amaargiru/openlight/Docs/pcb.jpg

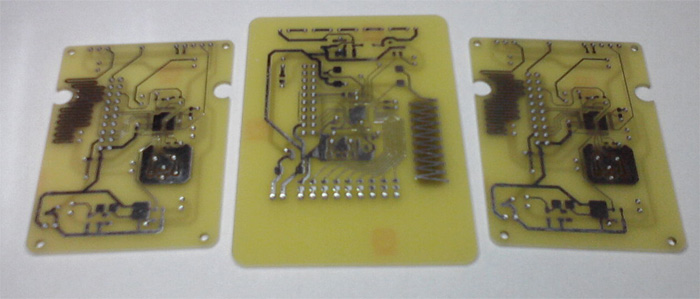
Docs/pcb.jpg
