amaargiru/openlight/README.md

# openlight
Open hardware DIY project of bicycle light with wireless control
