amaargiru/openlight/BOMs/side.bom.xls

Open Light Project, "Side" module, Bill of Materials (BOM)
RefDes | Part | Qty | Description
L1 | LQH32CN100K23L | 1 | SMD inductor
C1, C11 | 10 uF 1206 | 2 | SMD ceramic capacitor
C2 | 150 uF 6.3 V Case C | 1 | SMD tantalum capacitor
C3, C4, C7..C9, C10 | 0.1 uF 0805 | 6 | SMD ceramic capacitor
C5, C6 | 22 pF 0805 | 2 | SMD ceramic capacitor
D1 | STM32F100C4T6B | 1 | ARM Cortex M-3 microcontroller
D2 | TPS61041DBVR | 1 | DC/DC Boost Converter
G1 | 7.3728 MHz Quartz | 1 | HC49U Package
H1..H8 | DFL-5034 R1C-ESD-E | 8 | SuperBright Red LED 5 mm
R1 | 3.3 kOhm 0805 | 1 | SMD resistor
R2 | 82 Ohm 1206 | 1 | SMD resistor
U2 | RR8-433 | 1 | 433 MHz RF receiver
VD1 | MBR0530 | 1 | 0.5 A Schottky Rectifier
X1 | PLD-20 | 1 | 20 pin (2x10) 2.54 mm male JTAG Connector
