amaargiru/openlight/Schematics & PCBs/OL_head_02.pcb.pdf

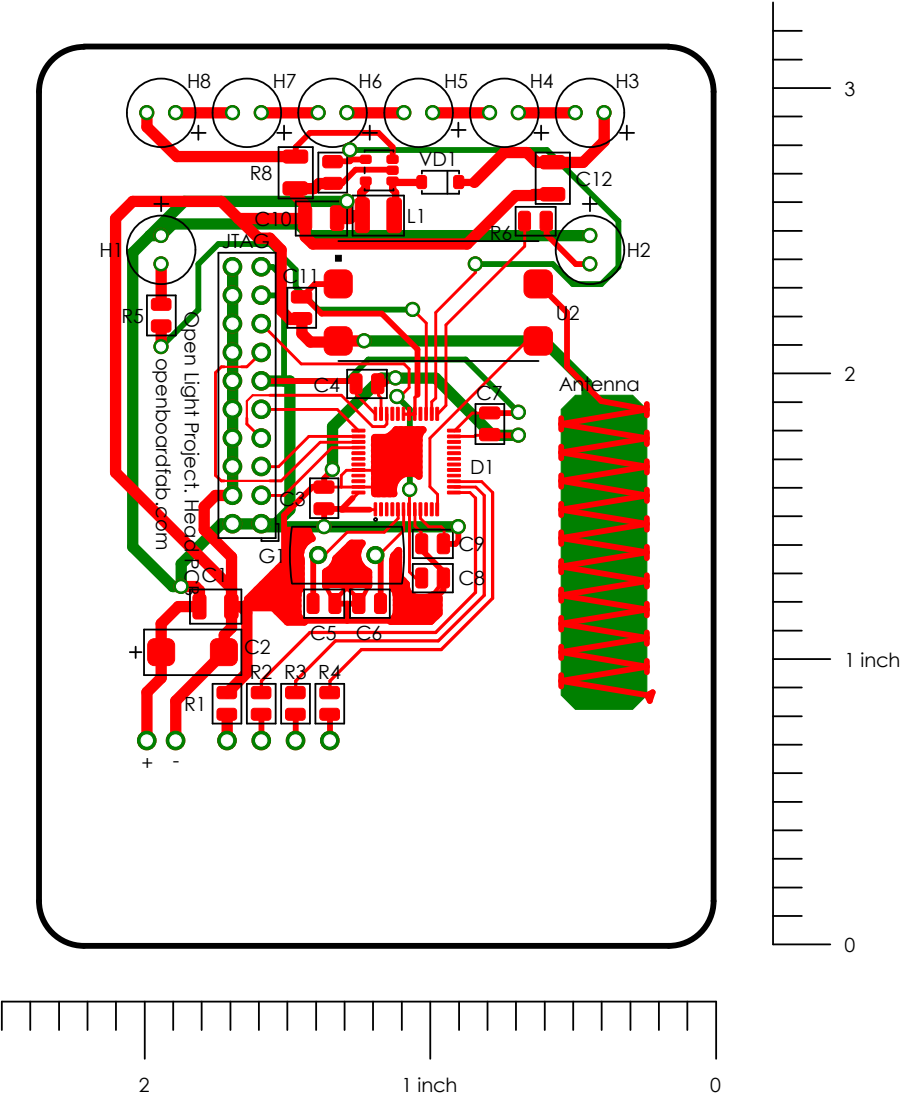
[picture p2: page 1]

Open Light Project. Head PCB
