amaargiru/openlight/Schematics & PCBs/OL_head_02.sch.pdf

# 12 PA2/TXD2/ADC2/TIM23 3

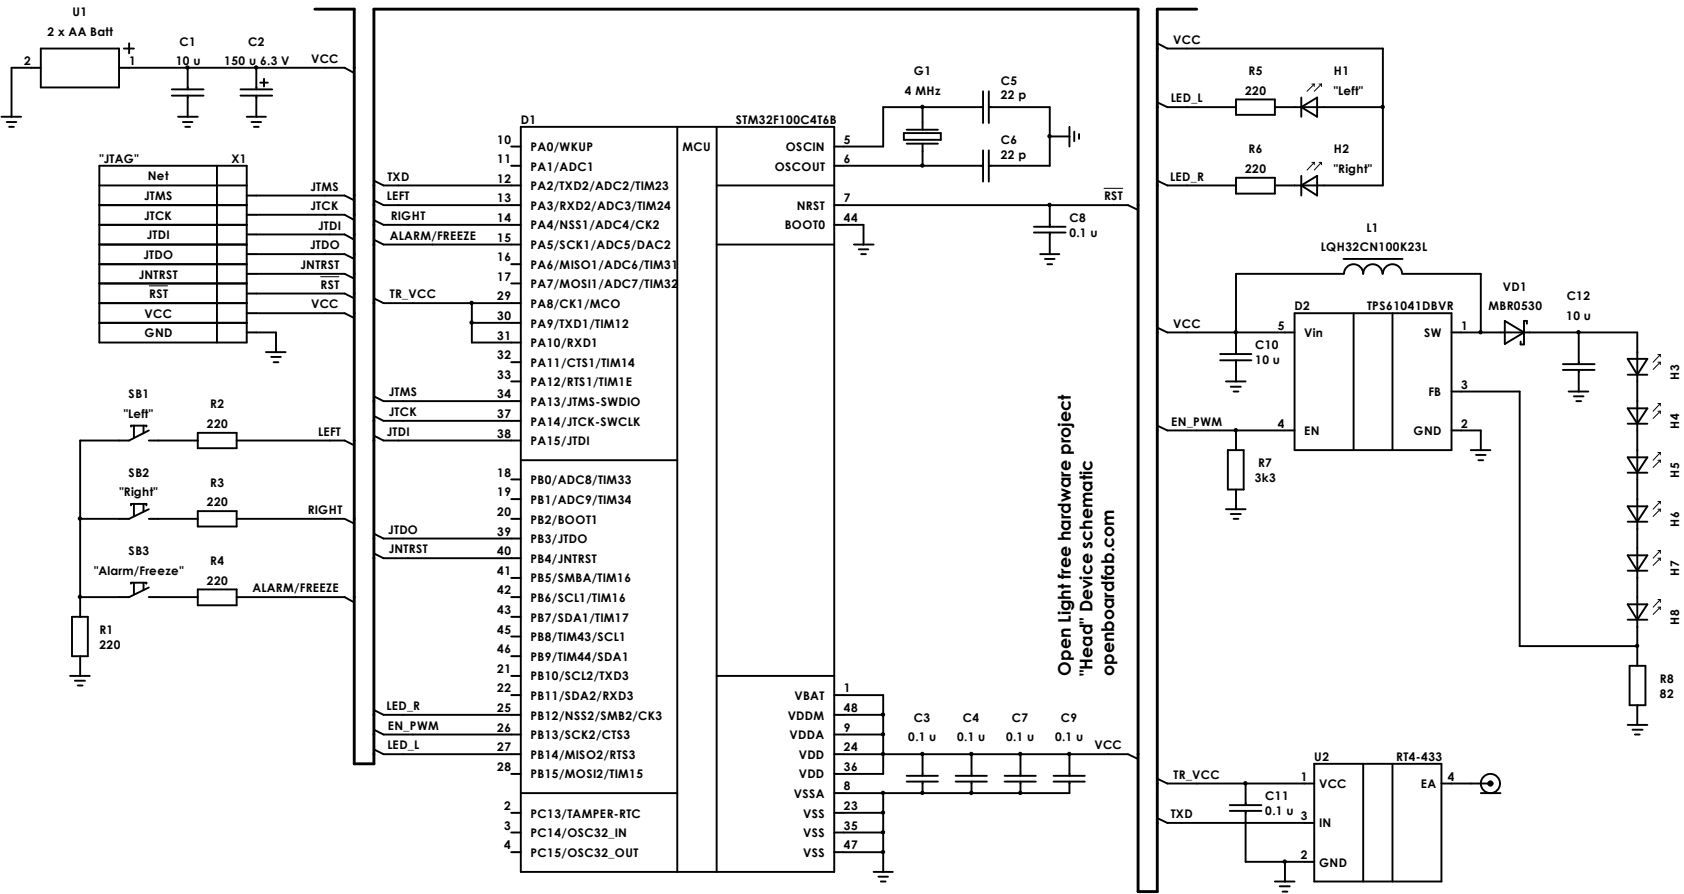
[picture p3: page 1]

JTDO
JNTRST

VCC
GND

Open Light free hardware project
