amaargiru/openlight/Schematics & PCBs/OL_side_02.pcb.pdf

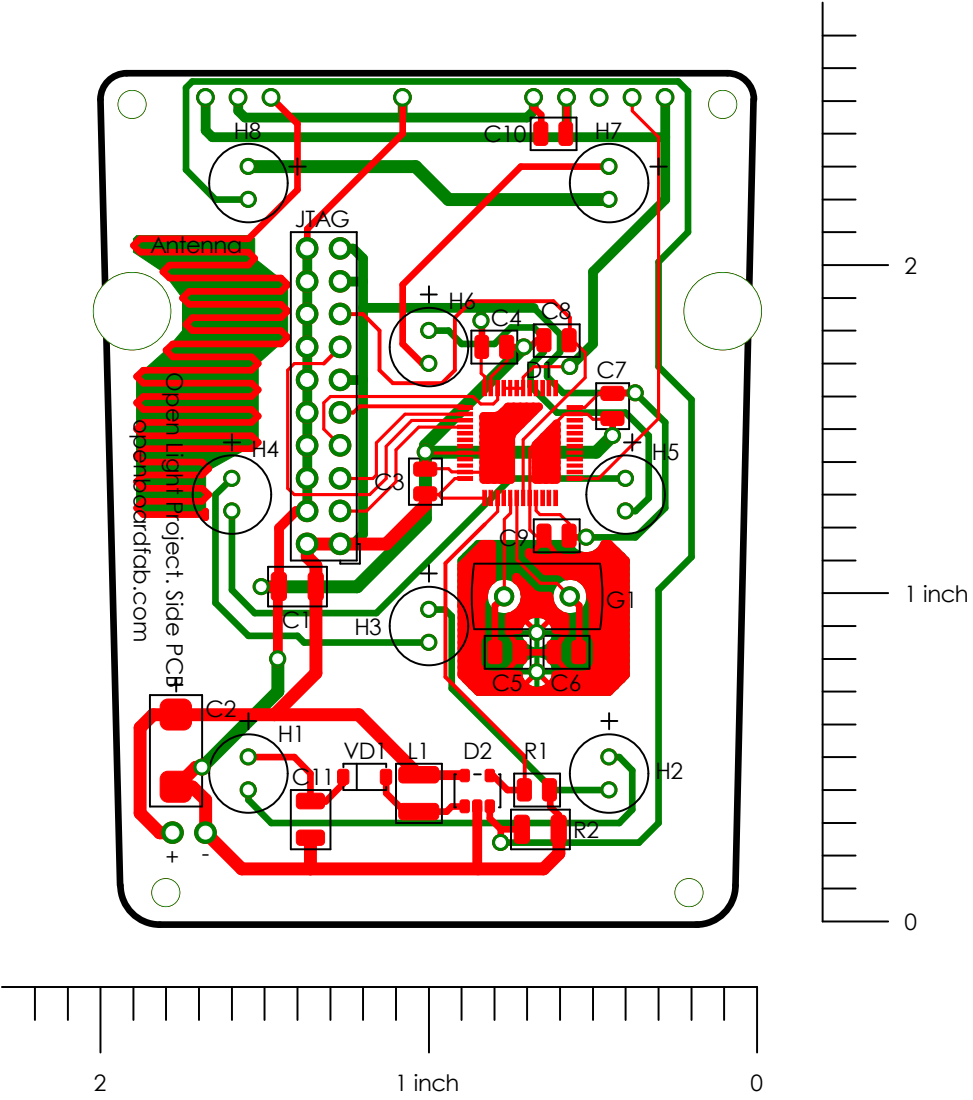
[picture p4: page 1]

Open Light Project. Side PCB
