amaargiru/openlight/Schematics & PCBs/OL_side_02.sch.pdf

# 12 PA2/TXD2/ADC2/TIM23 3

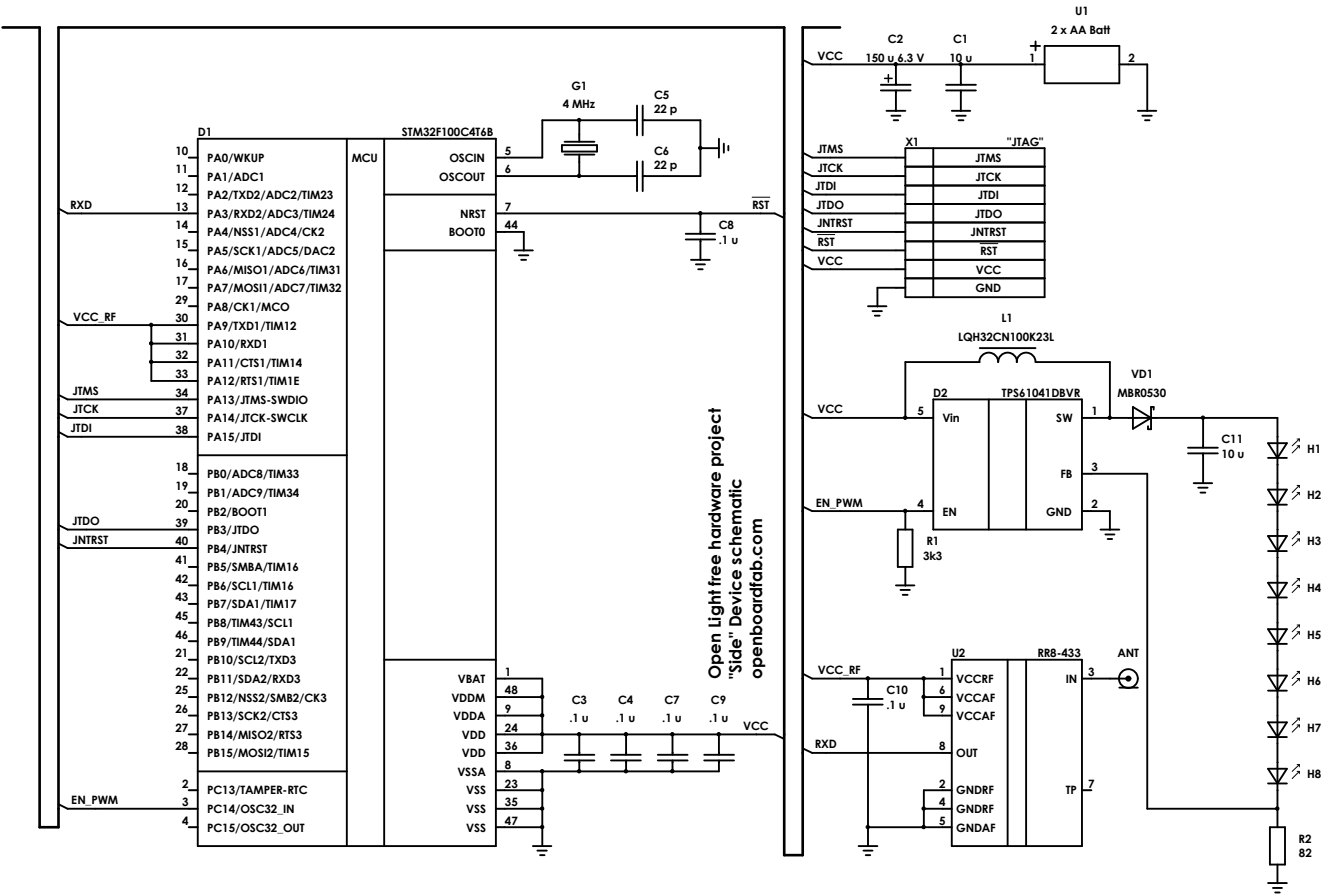
[picture p5: page 1]

JTMS
JTCK
JTDI
JTDO
JNTRST
RST
VCC
GND

Open Light free hardware project
