amaargiru/openlight/Schematics & PCBs/OL_head_02.pcb.bottom.pdf

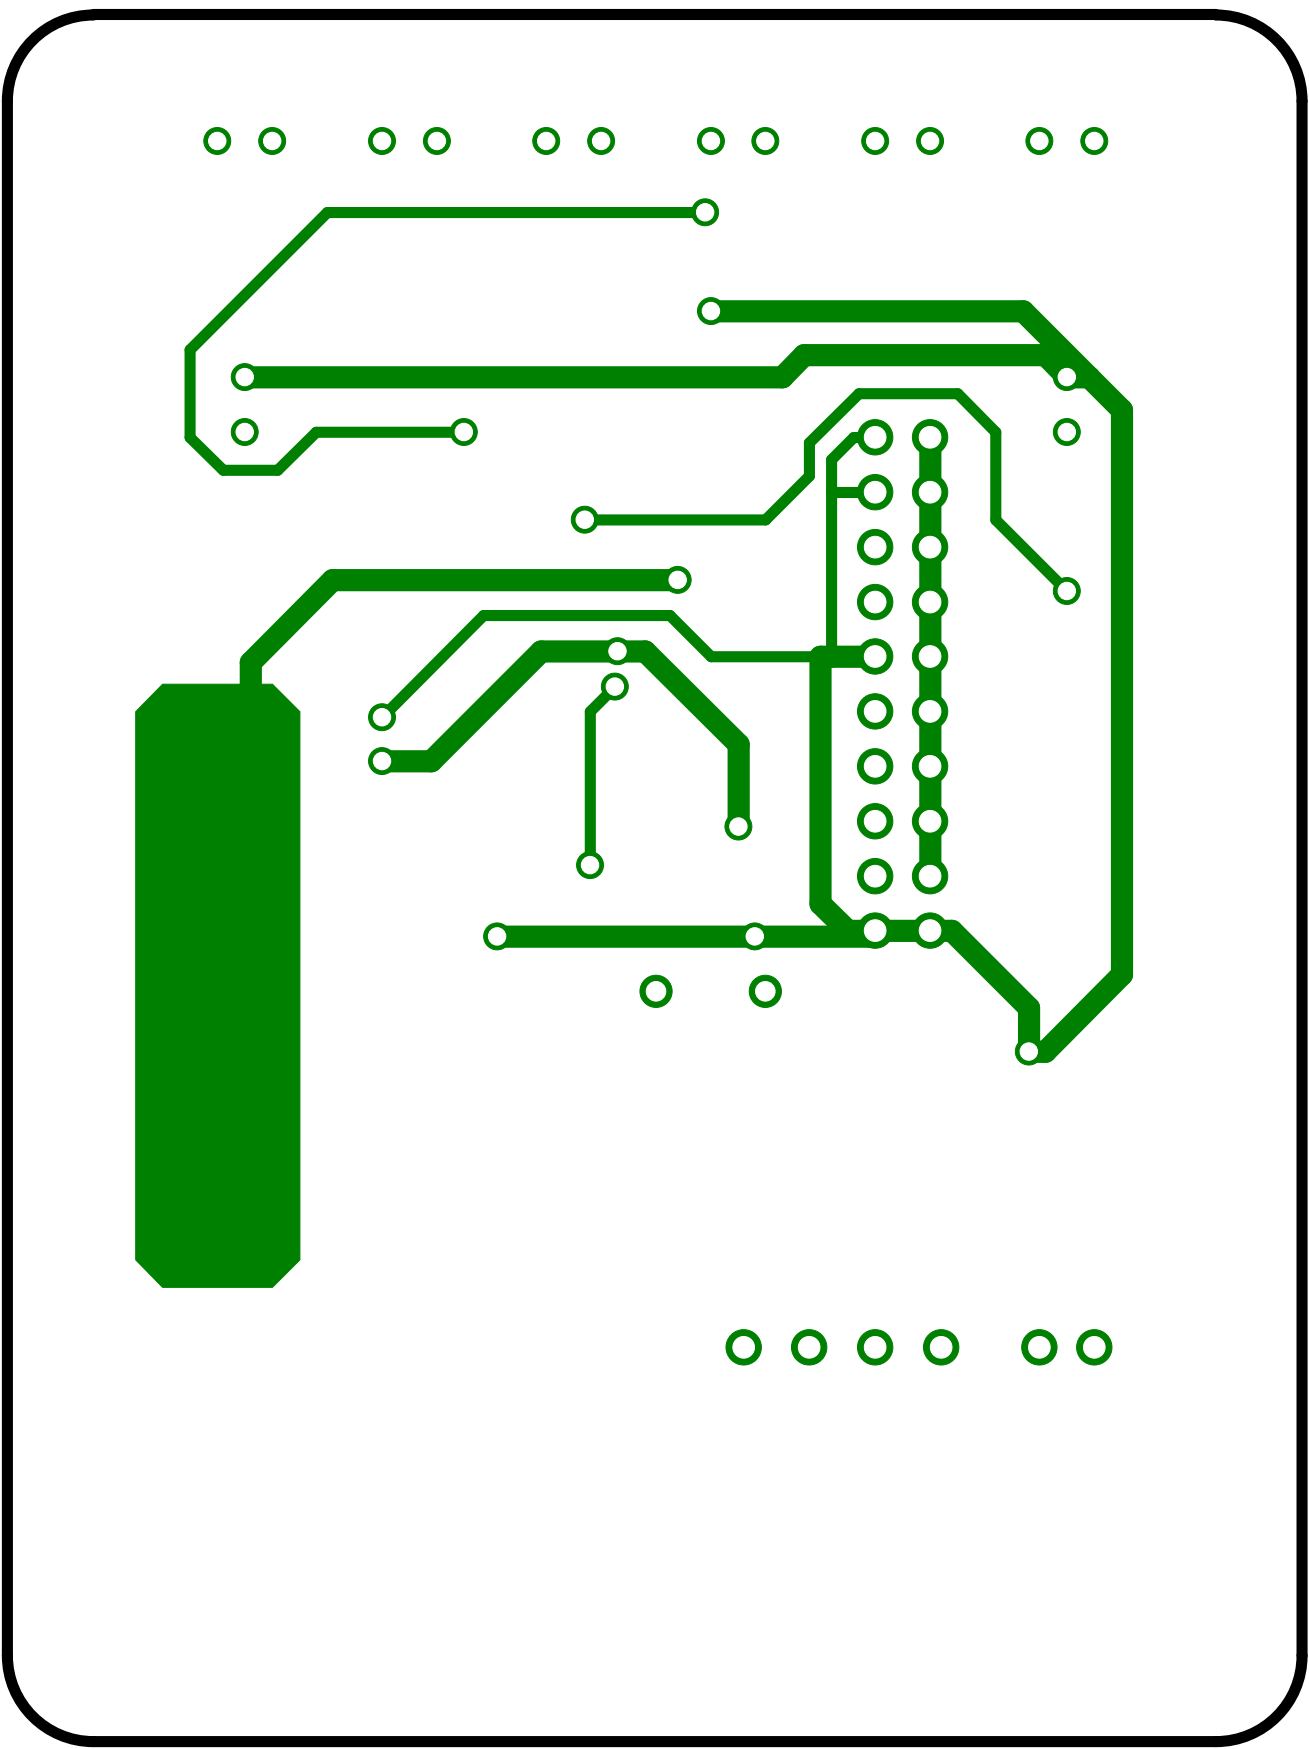
[picture p6: page 1]
