amaargiru/openlight/Schematics & PCBs/OL_head_02.pcb.top.pdf

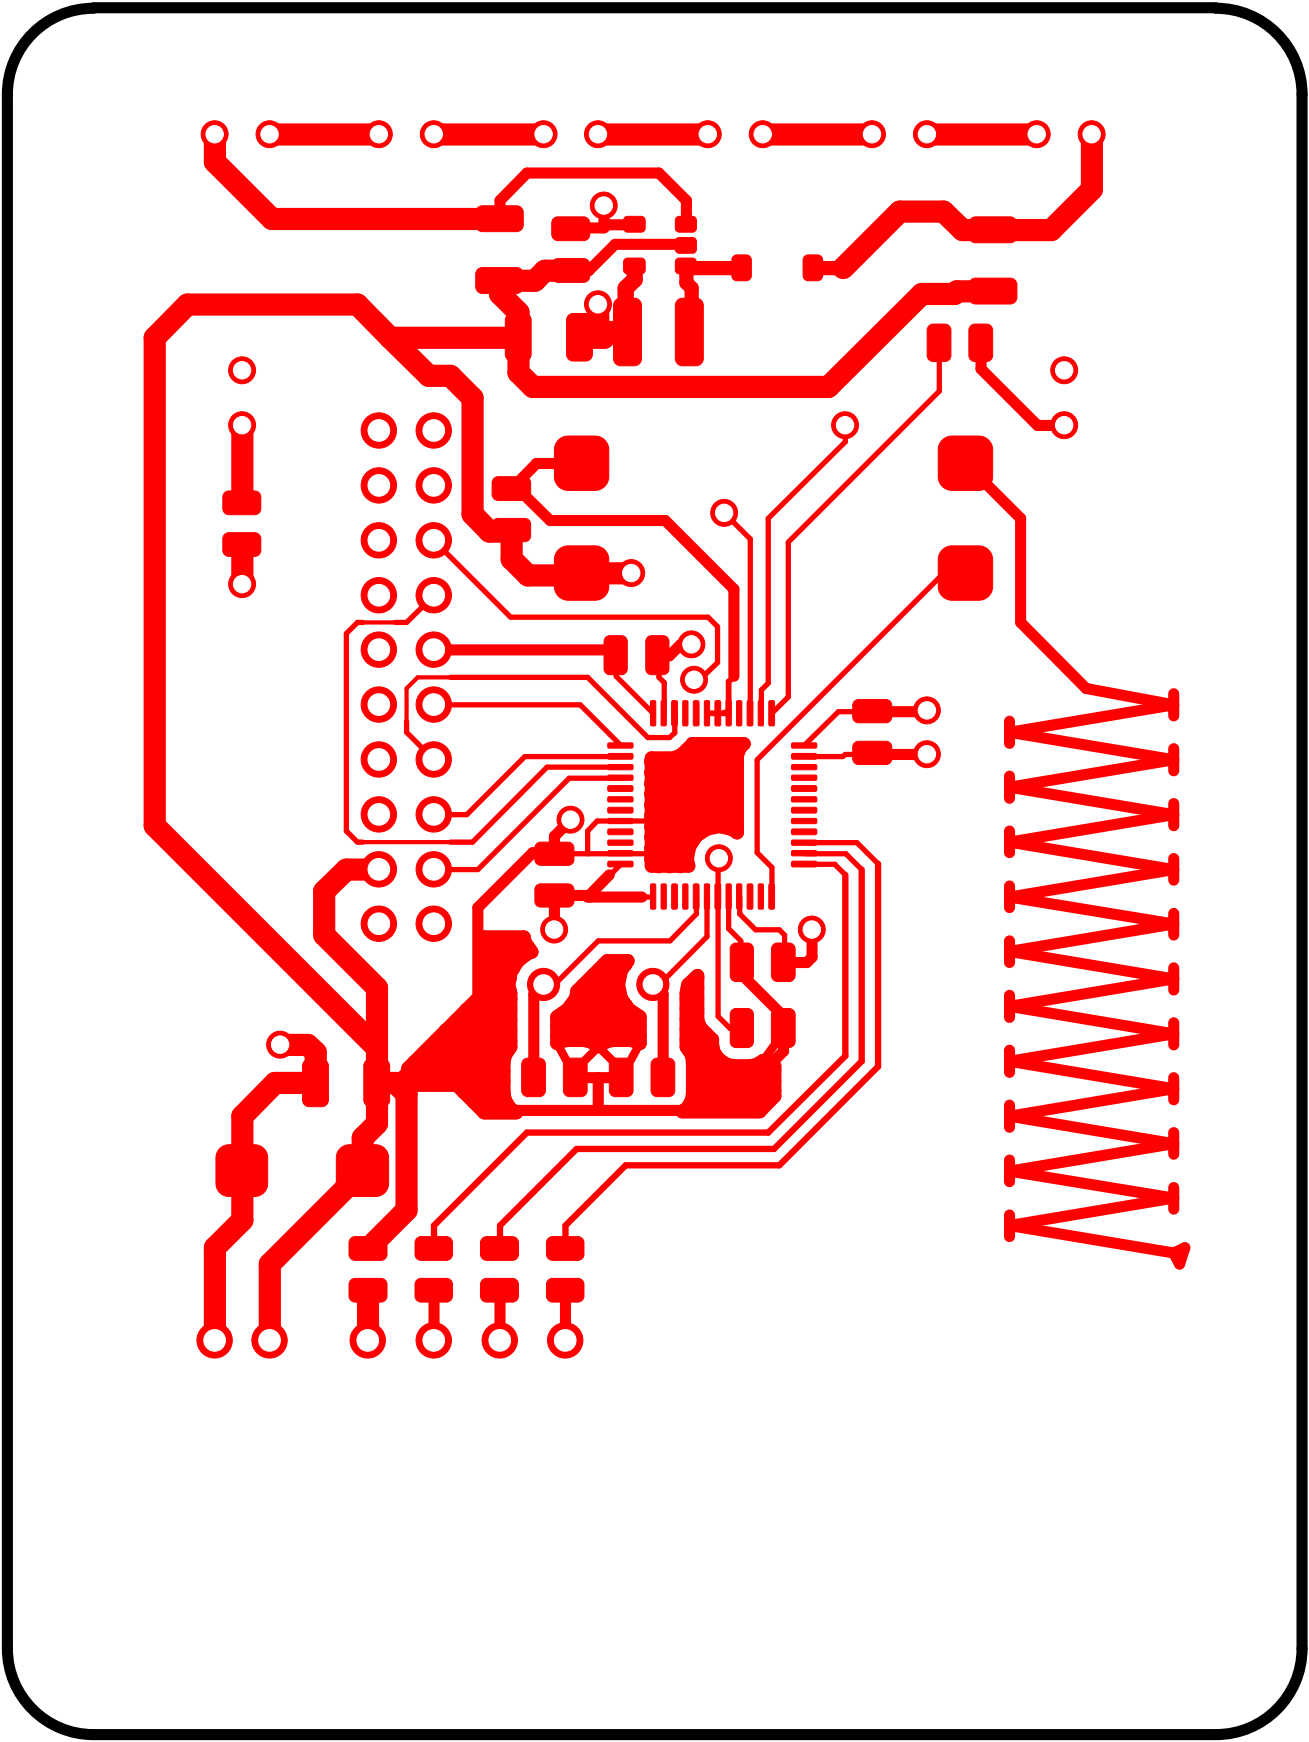
[picture p7: page 1]
