amaargiru/openlight/Schematics & PCBs/OL_side_02.pcb.bottom.pdf

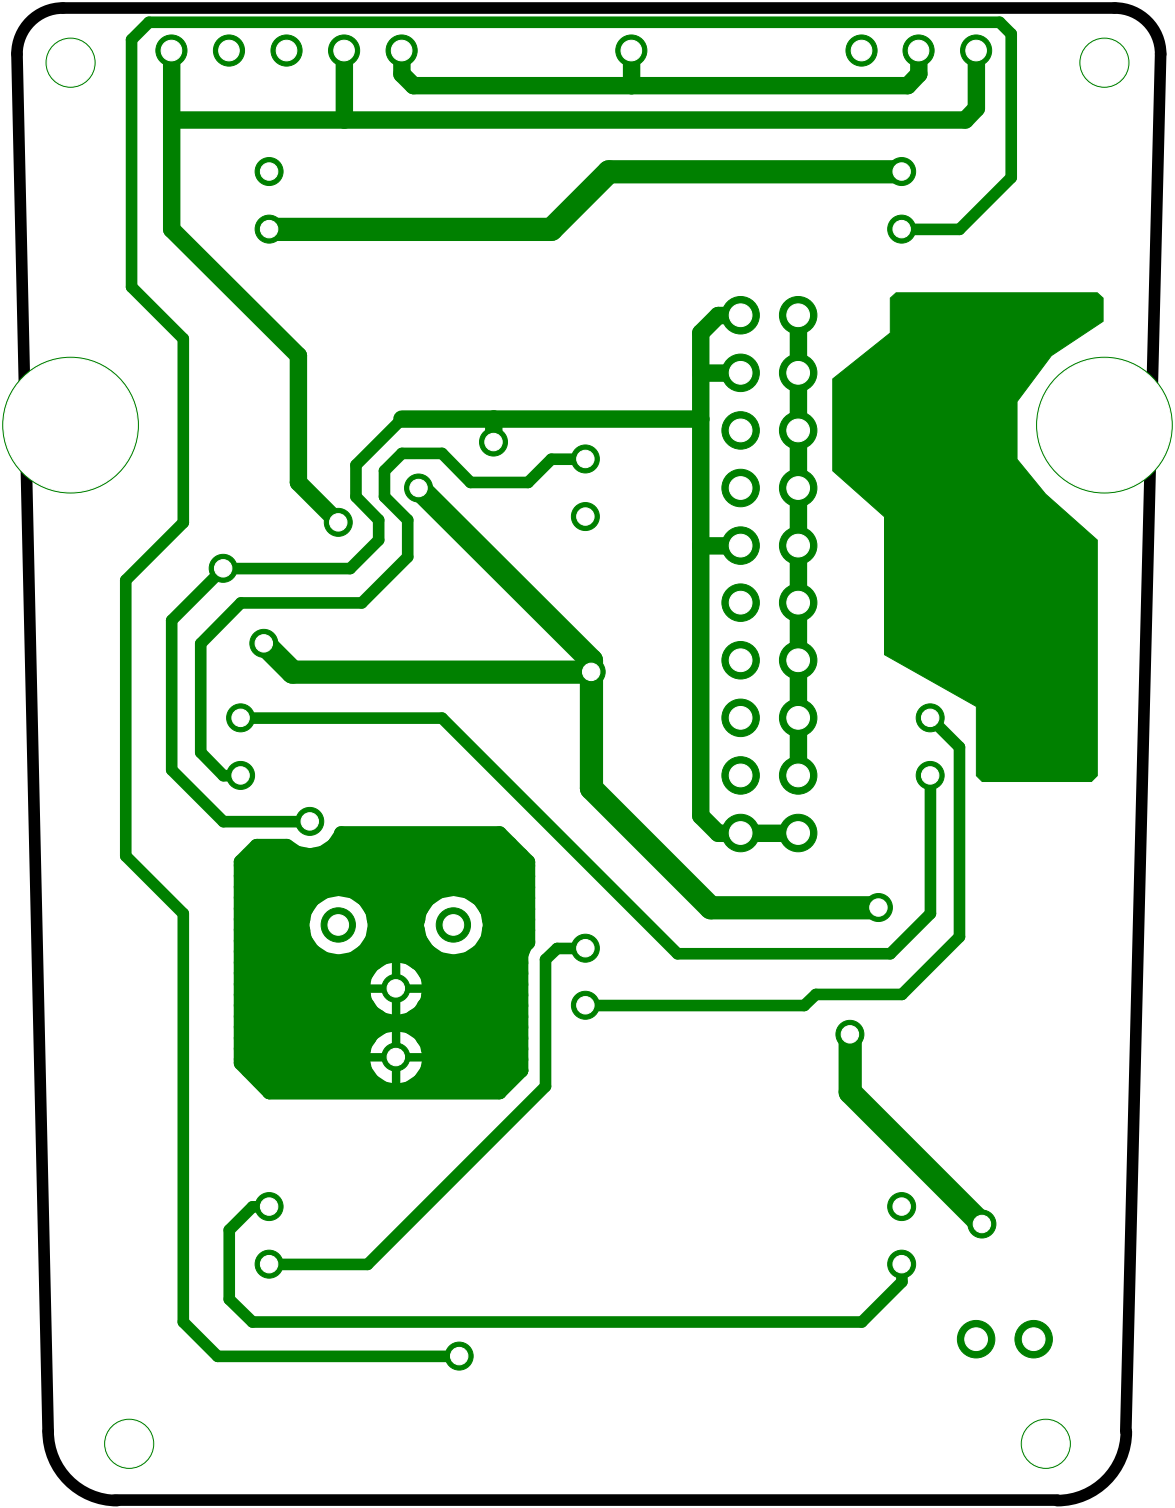
[picture p8: page 1]
