amaargiru/openlight/Schematics & PCBs/OL_side_02.pcb.top.pdf

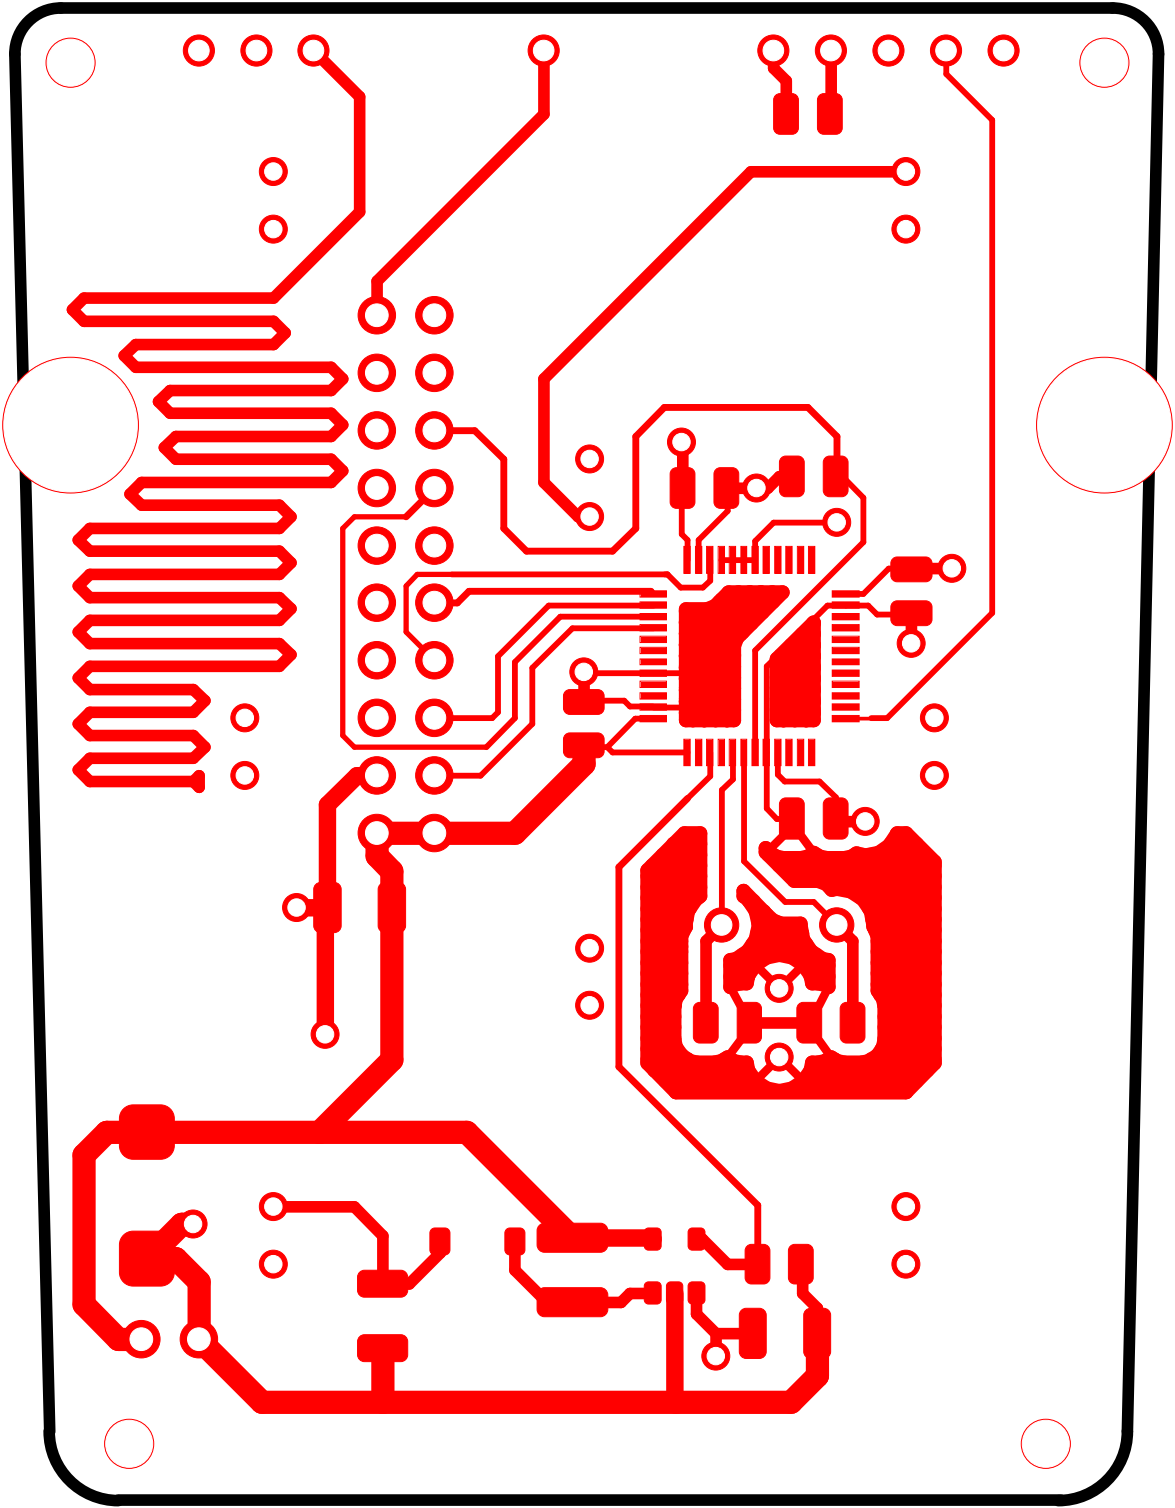
[picture p9: page 1]
