amaargiru/openlight/(list of files, drawings)

Other design files:
Schematics & PCBs/OL_head_02.pcb
Schematics & PCBs/OL_side_02.pcb
